yyc001/xrg/(commit log)

2022-04-25 add ins
    [i_program_table.csv, u_program.csv]
2023-03-24 add 实验报告
